smaria/sailing-robot-cape/partlist.xlsx

 | PCS | order | cost | Farnell partnumber | link | Notes
 | per assembly |  | In £
General
2 cape pin headers, 23x2 | 2 | 5 | 9.4 | 2025431 | http://uk.farnell.com/jsp/search/productdetail.jsp?sku=2025431
Power supply
Battery holder (AAA) | 2 |  | no stock | 1650687 | http://uk.farnell.com/keystone/2482/battery-holder-leaded-4-aaa/dp/1650687
 |  | 2 | 1.44 | rs-online | http://uk.rs-online.com/web/p/battery-holders-mounts/5123568/
AAA battery | 8 | 0
DC/DC converter | 1 | 1 | 4.8 | 1696320 | http://uk.farnell.com/tracopower/tsr-1-2450/converter-dc-dc-5v-1a-sip/dp/1696320?Ntt=1696320
Linear regulator | 0 | 1 | 6.24 | 1273643 | http://uk.farnell.com/linear-technology/lt323at-pbf/reg-controller-smd-to-220-3-323/dp/1273643 | 3 A
too high temperature!!! | 0 | 1 | 0.35 | 2296029 | http://uk.farnell.com/micro-commercial-components/mc7805ct-bp/ldo-2vdo-1a-5v-3to220/dp/2296029 | 2.2 A
JST connector 2mm, 2way | 2 | 10 | 2.31 | 9492534 | http://uk.farnell.com/jst-japan-solderless-terminals/b2b-ph-sm4-tb-lf-sn/connector-header-smt-2mm-2way/dp/9492534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
JST housing, 2way plug | 2 | 10 | 0.34 | 3616186 | http://uk.farnell.com/jst-japan-solderless-terminals/phr-2/housing-2way-2mm/dp/3616186
JST crimp contact | 4 | 100 | 3 | 3617210 | http://uk.farnell.com/jst-japan-solderless-terminals/bph-002t-p0-5s/contact-loose-piece-0-05-0-22mm/dp/3617210
LEDs + Servos
Common GND red/green LEDs | 6 | 0
470 Ohm resistor | 12 | 50 | 0.4 | 1700232 | http://uk.farnell.com/jsp/search/productdetail.jsp?sku=1700232
pin header smd | 4 | 10 | 5.8 | 2356218 | http://uk.farnell.com/wurth-elektronik/61000621121/header-2-54mm-pin-smt-r-a-6way/dp/2356218
1k Ohm resistor | 2 | 50 | 0.8 | 1700237 | http://uk.farnell.com/jsp/search/productdetail.jsp?sku=1700237
GPS2
supervisor circuit | 1 | 2 | 5.12 | 1188029 | http://uk.farnell.com/maxim-integrated-products/max809seur-t/supervisor-circuit-5-5v-3sot23/dp/1188029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
gps | 1 | 0
0.1uF capacitor | 1 | 2 | 0.22 | 1288255 | http://uk.farnell.com/jsp/search/productdetail.jsp?sku=1288255
GPS1
Max-7 gps breakout w. sarantel antenna | 1 | 1 | 29.99 | - | http://ava.upuaut.net/store/index.php?route=product/product&path=59_60&product_id=51
smd receptacle 1x8 | 1 | 2 | 3.48 | 1668259 | http://uk.farnell.com/samtec/ssm-108-l-sv/receptacle-2-54mm-vert-8way/dp/1668259
IMU
smd receptacle 1x4 | 1 | 2 | 2.38 | 1668251 | http://uk.farnell.com/jsp/search/productdetail.jsp?sku=1668251
xBee
smd receptacle 1x10, 1mm | 2 | 4 | 8.96 | 1668127 | http://uk.farnell.com/jsp/search/productdetail.jsp?sku=1668127
Multiplexer?
 |  |  |  |  | https://www.tindie.com/products/bot_thoughts/rc-rovermux-for-self-driving-robots/ |  | http://www.bot-thoughts.com/2013/07/rover-rc-multiplexer.html
 |  |  |  |  | http://www.pololu.com/product/2806
 |  |  | 50.24 | plus | 36 | plus ca. | 10 | -> | 96.24 | GBP
 |  |  |  |  | (GPS, incl shipping) |  | (Multiplexer)
