smaria/sailing-robot-cape/BBBBoat-cape.brd

## EAGLE design BBBBoat-cape.brd (2014-08-20)

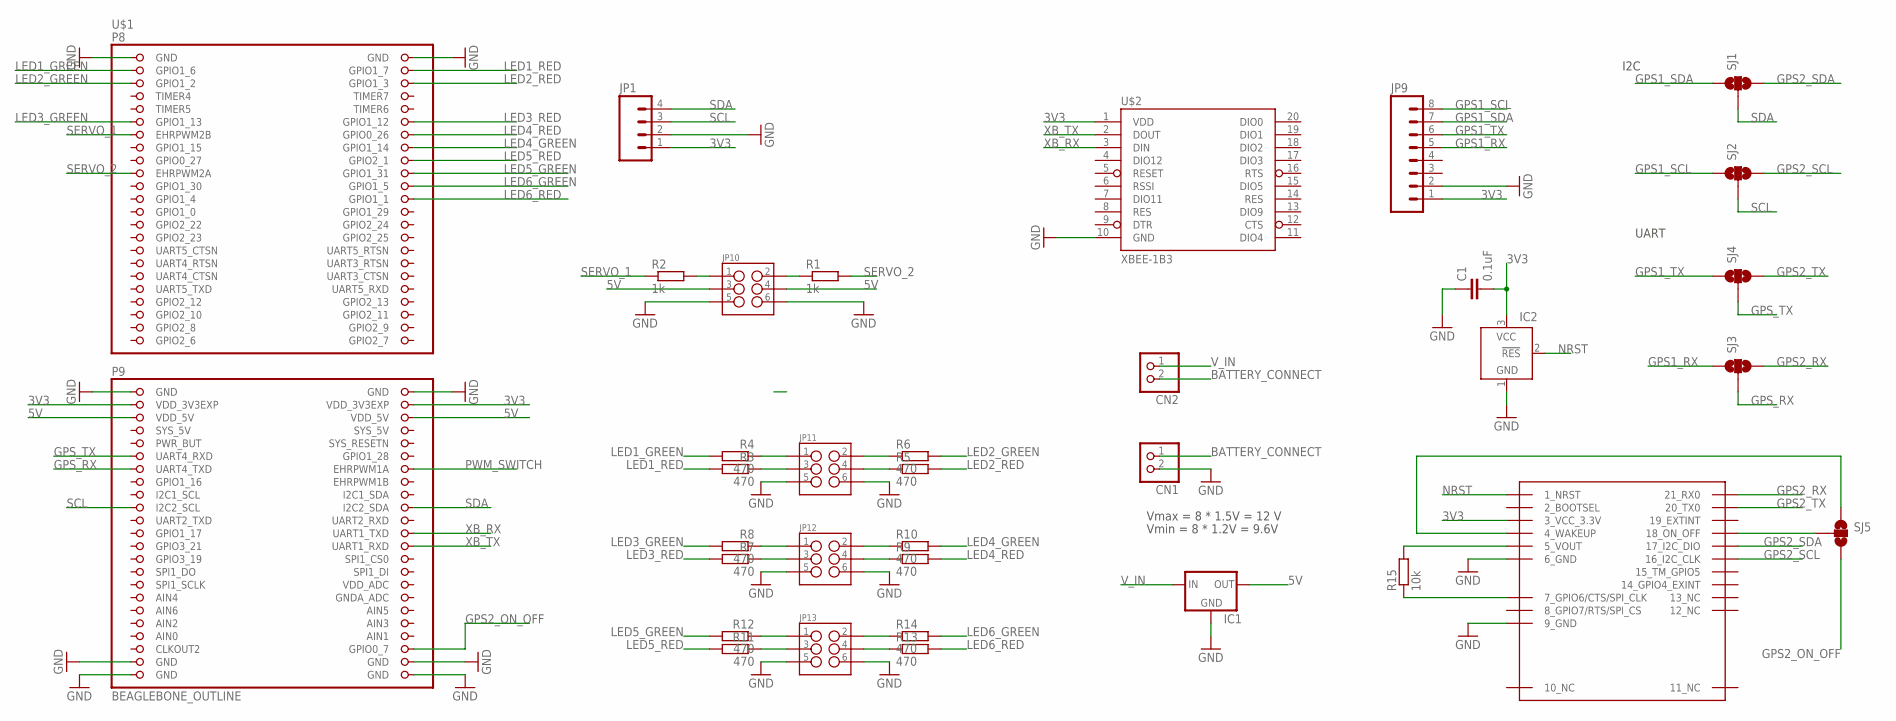
[picture p1: schematic BBBBoat-cape.sch]

Parts:
C1: 0.1uF; 0603-CAP
CN1, CN2: JST_2PIN-SMT; JST-PH-2-SMT
IC1: V_REG_78XX-TO-220; TO-220-ALT
IC2: TCM809; SOT23B-3
JP1: M04SMD_STRAIGHT_COMBO; 1X04_SMD_STRAIGHT_COMBO
JP9: M08SMD-MALE; 1X08_SMD_MALE
JP10, JP11, JP12, JP13: M03X2; 2X3_SMD
R1, R2: 1k; 0204/7
R3, R4, R5, R6, R7, R8, R9, R10, R11, R12, R13, R14: 470; 0204/7
R15: 10k; 0204/7
SJ1, SJ2, SJ3, SJ4, SJ5: SOLDERJUMPER_2WAYT; SJ_2
U$1: BEAGLEBONE_OUTLINE; BEAGLEBONE_SHIELD
U$2: XBEE-1B3; XBEE-SMD
U$3: A2035-H; A2035H

Connections:
3V3: C1.2, IC2.3 (VCC), JP1.1, JP9.1, U$1.49 (VDD_3V3EXP), U$1.50 (VDD_3V3EXP), U$2.1 (VDD), U$3.3_VCC_3.3V
5V: IC1.OUT, JP10.3, JP10.4, U$1.51 (VDD_5V), U$1.52 (VDD_5V)
AIN0: U$1.85 (AIN0)
BATTERY_CONNECT: CN1.1 (2), CN2.2 (1)
GND: C1.1, CN1.2 (1), IC1.GND, IC2.1 (GND), JP1.2, JP9.2, JP10.5, JP10.6, JP11.5, JP11.6, JP12.5, JP12.6, JP13.5, JP13.6, U$1.1 (GND), U$1.2 (GND), U$1.47 (GND), U$1.48 (GND), U$1.89 (GND), U$1.90 (GND), U$1.91 (GND), U$1.92 (GND), U$2.10 (GND), U$3.6_GND, U$3.9_GND
GPS1_RX: JP9.5, SJ3.1
GPS1_SCL: JP9.8, SJ2.1
GPS1_SDA: JP9.7, SJ1.1
GPS1_TX: JP9.6, SJ4.1
GPS2_ON_OFF: SJ5.3, U$1.88 (GPIO0_7)
GPS2_RX: SJ3.3, U$3.21_RX0
GPS2_SCL: SJ2.3, U$3.16_I2C_CLK
GPS2_SDA: SJ1.3, U$3.17_I2C_DIO
GPS2_TX: SJ4.3, U$3.20_TX0
GPS_RX: SJ3.2, U$1.59 (UART4_TXD)
GPS_TX: SJ4.2, U$1.57 (UART4_RXD)
LED1_GREEN: R4.2, U$1.3 (GPIO1_6)
LED1_RED: R3.2, U$1.4 (GPIO1_7)
LED2_GREEN: R6.2, U$1.5 (GPIO1_2)
LED2_RED: R5.2, U$1.6 (GPIO1_3)
LED3_GREEN: R8.2, U$1.11 (GPIO1_13)
LED3_RED: R7.2, U$1.12 (GPIO1_12)
LED4_GREEN: R10.2, U$1.16 (GPIO1_14)
LED4_RED: R9.2, U$1.14 (GPIO0_26)
LED5_GREEN: R12.2, U$1.20 (GPIO1_31)
LED5_RED: R11.2, U$1.18 (GPIO2_1)
LED6_GREEN: R14.2, U$1.22 (GPIO1_5)
LED6_RED: R13.2, U$1.24 (GPIO1_1)
unnamed: JP11.3, R3.1
unnamed: JP11.1, R4.1
unnamed: JP11.4, R5.1
unnamed: JP11.2, R6.1
unnamed: JP12.3, R7.1
unnamed: JP12.1, R8.1
unnamed: JP12.4, R9.1
unnamed: JP12.2, R10.1
unnamed: JP13.3, R11.1
unnamed: JP13.1, R12.1
unnamed: JP13.4, R13.1
unnamed: JP13.2, R14.1
unnamed: R15.1, U$3.7_GPIO6/CTS/SPI_CLK
unnamed: JP10.2, R1.1
unnamed: R15.2, U$3.5_VOUT
unnamed: JP10.1, R2.2
unnamed: SJ5.2, U$3.18_ON_OFF
unnamed: SJ5.1, U$3.4_WAKEUP
NRST: IC2.2 (!RES), U$3.1_NRST
PWM_SWITCH: U$1.60 (EHRPWM1A)
SCL: JP1.3, SJ2.2, U$1.65 (I2C2_SCL)
SDA: JP1.4, SJ1.2, U$1.66 (I2C2_SDA)
SERVO_1: R2.1, U$1.13 (EHRPWM2B)
SERVO_2: R1.2, U$1.19 (EHRPWM2A)
SYS_5V: U$1.53 (SYS_5V)
V_IN: CN2.1 (2), IC1.IN
XB_RX: U$1.70 (UART1_TXD), U$2.3 (DIN)
XB_TX: U$1.72 (UART1_RXD), U$2.2 (DOUT)

Notes on the sheet:
Vmax = 8 * 1.5V = 12 V
Vmin = 8 * 1.2V = 9.6V
I2C
UART

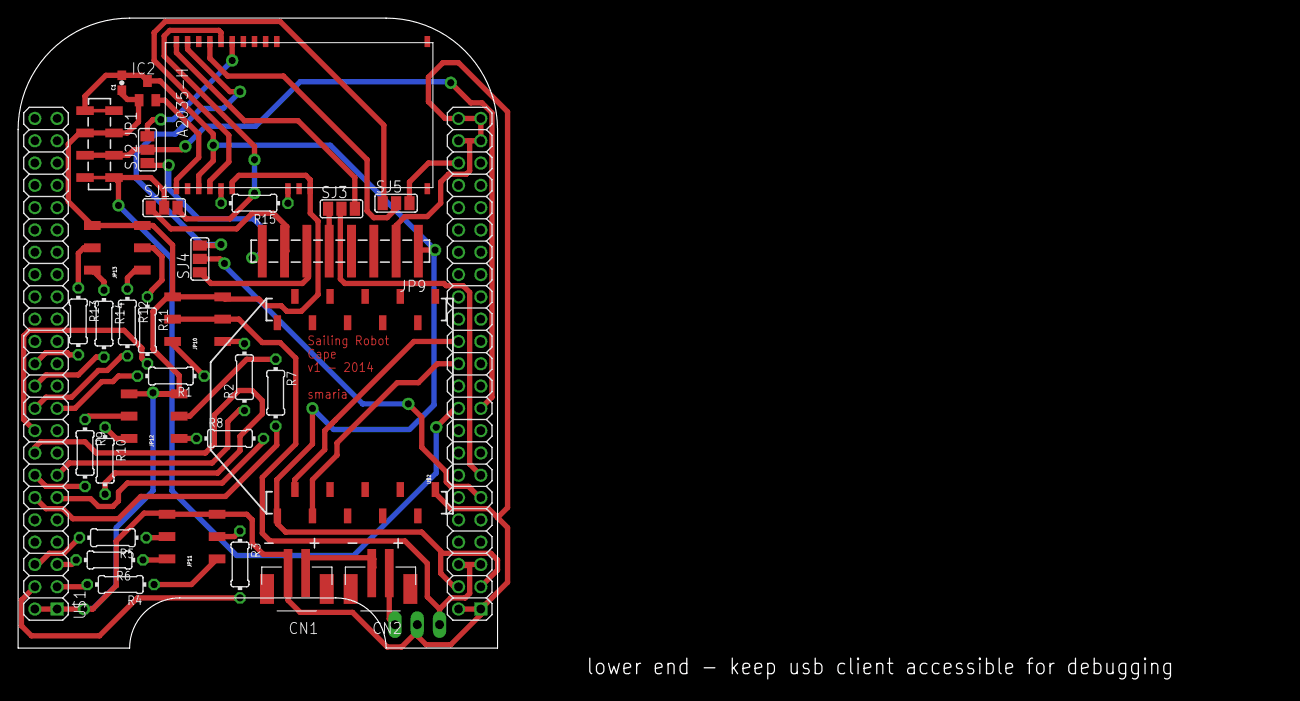
[picture p2: board BBBBoat-cape.brd from above]

Board: 2 copper layers, 54.6 x 71.8 mm, 34 parts (1 on the bottom side), 53 nets.
