smaria/sailing-robot-cape/(commit log)

2014-08-10 add eagle files that are being made now
    BBBBoat cape v1, as they are being etched right now
    Since its only a one sided etch without vias, most parts were chosen
    to be smd
    [BBBBoat-cape.brd, BBBBoat-cape.sch]
2014-08-10 partlist for the sailing robot cape
    [partlist.xlsx]
2014-08-14 mark arrived parts
    [partlist.xlsx]
2014-08-14 correct jst smd connector part number
    the ordered connector is the wrong type,
    it is flat on the pcb when it should be standing up
    [partlist.xlsx]
2014-08-18 correct DC/DC converter
    the linear regulators heat up too much/need to large heat sinks
    so they are replaced with a switching regulator
    [partlist.xlsx]
2014-08-20 change PWM pin
    the pwm B pins currently don't work in the PyBBIO library
    so PWM2B was switched to PWM1A
    [BBBBoat-cape.brd, BBBBoat-cape.sch]
2014-08-21 add notes on PWM, signal overlap on PCB, 5v supply
2014-08-21 add detail on servo motor power supply
